jamestiotio/ehp/README.md

# 50.002 1D Part 2: Electronic Hardware Project

SUTD ISTD 2020 Computation Structures Electronic Hardware Project: 16-Bit ALU, ALU Tester & Electronic Game.

Team 03-2:

- [James Raphael Tiovalen](https://github.com/jamestiotio) (Team Leader)
- [Ng Yu Yan](https://github.com/ngyy3487)
- [Sun Kairan](https://github.com/kairanskrr)
- [Cheow Wei Da Nicholas](https://github.com/nicholascwd)
- Jodi Tan Kai Yu
