jamestiotio/ehp/alu/README.md

# 16-Bit Arithmetic Logic Unit (ALU) & ALU Tester

SUTD ISTD 2020 Computation Structures 1D ALU Project.

Team 03-2:

- [James Raphael Tiovalen](https://github.com/jamestiotio) (Team Leader)
- [Ng Yu Yan](https://github.com/ngyy3487)
- [Sun Kairan](https://github.com/kairanskrr)
- [Cheow Wei Da Nicholas](https://github.com/nicholascwd)
- Jodi Tan Kai Yu

## Introduction

In this project, we implemented an Arithmetic Logic Unit (ALU) and its tester in the Alchitry Au FPGA.

## Features

This is the instruction set for the ALU.

> NOTE: X would indicate that that particular bit's value does not matter (whether it is a 0 or 1). In other words, we do not care about the value of the X bit.

| ALUFN[5:0] | Operation | Module |
| --- | --- | --- |
| 00 00X0 | ADD | adder16 |
| 00 00X1 | SUBTRACT | adder16 |
| 00 0100 | MULTIPLY | multiplier16 |
| 00 0101 | FLOOR DIVISION | multiplier16 |
| 00 0110 | SIGNED MODULO | multiplier16 |
| 00 0111 | UNSIGNED MODULO | multiplier16 |
| 00 1000 | INCREMENT X | increment16  |
| 00 1001 | INCREMENT Y | increment16  |
| 00 1010 | DECREMENT X | decrement16  |
| 00 1011 | DECREMENT Y | decrement16  |
| 00 11XX | FACTORIAL | factorial |
| 01 0000 | ZERO | boolean16 |
| 01 0001 | NOR | boolean16 |
| 01 0010 | NOT CONVERSE | boolean16 |
| 01 0011 | NOT 'X' | boolean16 |
| 01 0100 | NOT IMPLY | boolean16 |
| 01 0101 | NOT 'Y' | boolean16 |
| 01 0110 | XOR | boolean16 |
| 01 0111 | NAND | boolean16 |
| 01 1000 | AND | boolean16 |
| 01 1001 | XNOR | boolean16 |
| 01 1010 | 'X' | boolean16 |
| 01 1011 | IMPLY | boolean16 |
| 01 1100 | 'Y' | boolean16 |
| 01 1101 | CONVERSE | boolean16 |
| 01 1110 | OR | boolean16 |
| 01 1111 | ONE | boolean16 |
| 10 0000 | SHIFT LEFT | shifter16 |
| 10 0001 | SHIFT RIGHT | shifter16 |
| 10 0011 | SHIFT RIGHT ARITHMETIC | shifter16 |
| 10 0100 | ROTATE LEFT | shifter16 |
| 10 0101 | ROTATE RIGHT | shifter16 |
| 10 11XX | MIRROR | shifter16 |
| 11 001X | CMPEQ | comparator16 |
| 11 010X | CMPLT | comparator16 |
| 11 011X | CMPLE | comparator16 |
| 11 101X | MAXIMUM | comparator16 |
| 11 110X | MINIMUM | comparator16 |

## Testing

For the ALU tester, we also have two modes: manual and automatic.

To switch between automatic and manual testing mode, press `io_button[2]`.

> These are the in-built buttons of the Alchitry IO shield:
>
> - `io_button[0]` is the up/top button.
> - `io_button[1]` is the centre/middle button.
> - `io_button[2]` is the down/bottom button.
> - `io_button[3]` is the left button.
> - `io_button[4]` is the right button.

For both modes, you can force an error by pressing `io_button[0]` during either mode of testing. This will result in an error-catching state, which is for the purposes of intentional error handling/checking.

- Manual

  During manual testing mode, select the corresponding X and Y values by using `c{io_dip[1], io_dip[0]}`. Press `io_button[1]` to confirm the selected input values of X and Y accordingly and switch between inputting X, inputting Y and displaying the OUTPUT. The `c{io_led[1], io_led[0]}` will display the input values X and Y in real-time during their respective states. Select the associated OPCODE by using `io_dip[2][5:0]`. The OPCODE can be changed at any time and the corresponding correct OUTPUT will be displayed. The values of `io_dip[2][7:6]` will display the current state (10 when inputting X, 01 when inputting Y, and 11 when displaying OUTPUT). When the 7-segments display an "O" (i.e. at OUTPUT state), `c{io_led[1], io_led[0]}` will display the resulting output of the ALU.

- Automatic

  During automatic testing mode, the FSM will continuously cycle through the different test cases listed in the `auto_tester.luc` module. The 7-segments will cycle through this sequence for each test case: "X", INPUT_X, "Y", INPUT_Y, "O", EXPECTED_OUTPUT. As the automatic tester progresses through the pre-defined test cases, `io_led[2][5:0]` will display the current OPCODE function/instruction being tested. If an error is encountered, the letter "E" will be displayed on the 7-segments at the end of that test case. If the tester manages to go through all of the test cases successfully without any errors, the 7-segments will display a letter "d". Once one round of automatic testing is done, another round of automatic testing could be conducted by pressing `io_button[1]` in the `DONE` state without restarting/rebooting/repowering the FPGA.
