jamestiotio/ehp/game/docs/datapath.png

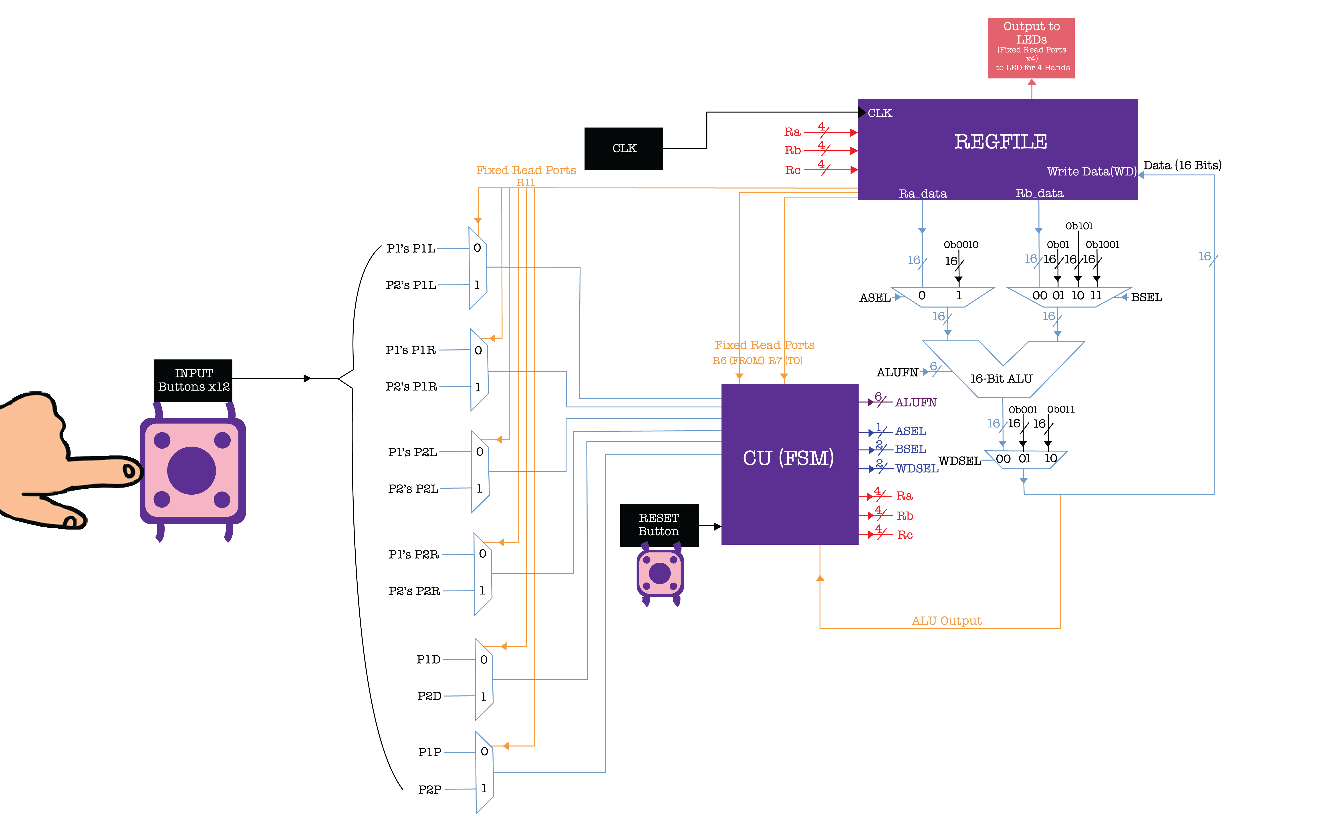
game/docs/datapath.png
