jamestiotio/ehp/game/docs/fsm.png

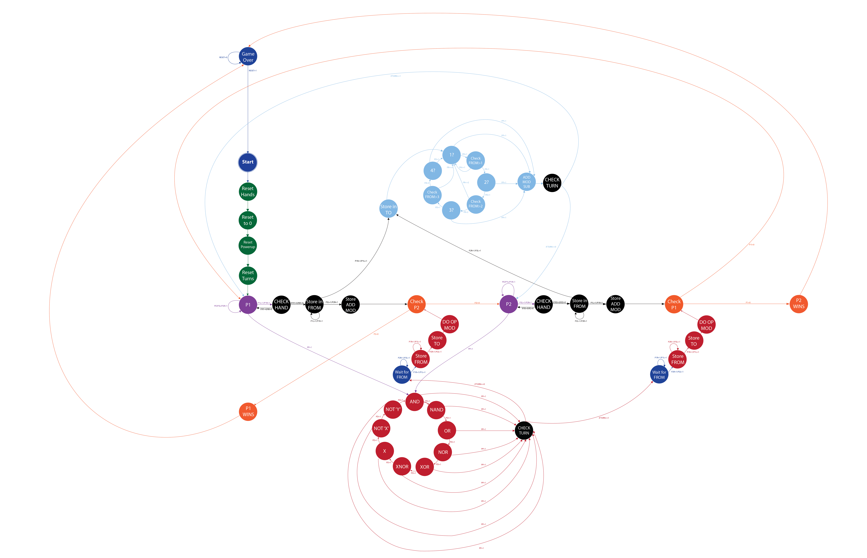
game/docs/fsm.png
