jamestiotio/ehp/game/docs/AlchitryBrElementReference.pdf

# Br Element Reference Notconnected

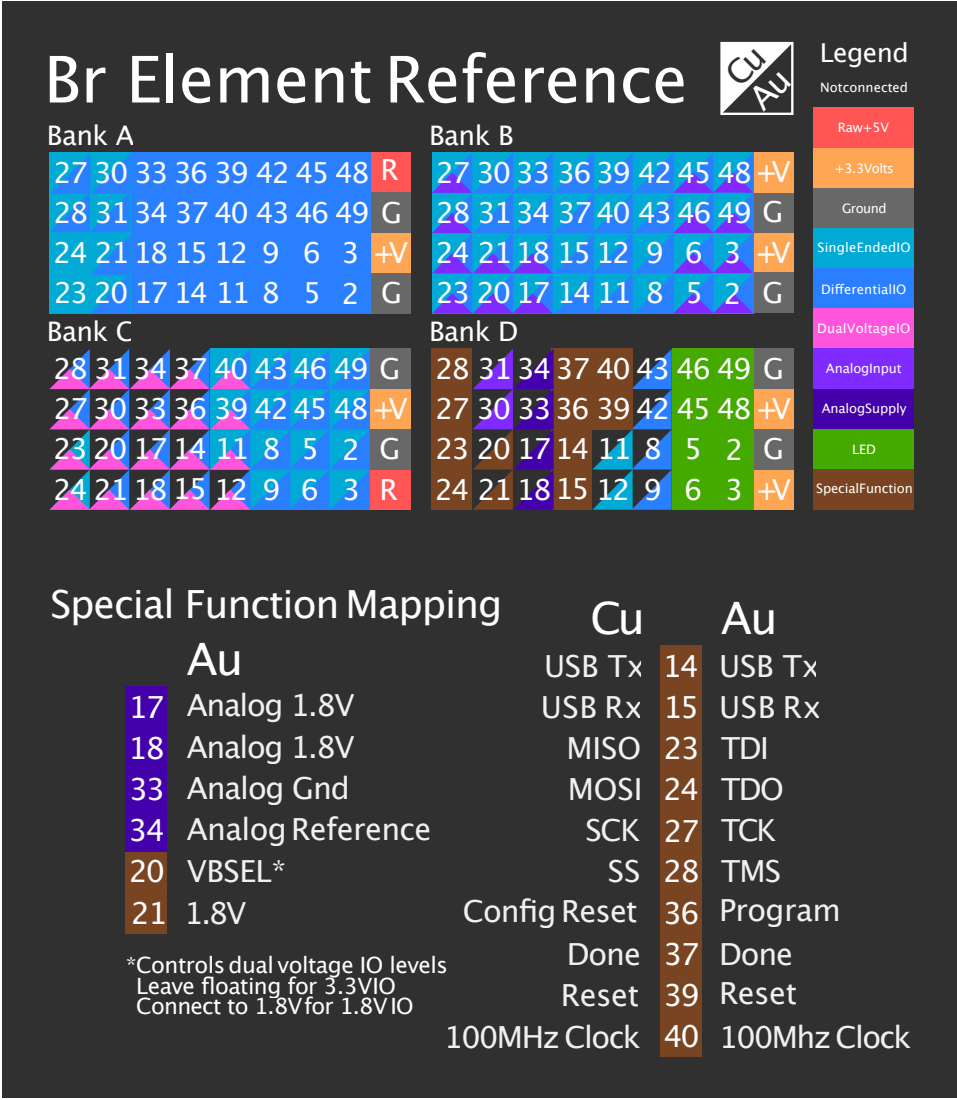
[picture p17: page 1]
Special Function Mapping; VBSEL*; USB Tx; USB Rx; ConfigReset; Program; Done; Reset; 100MHzClock; 100MhzClock; Analog 1.8V; MISO; TDI; Analog Gnd; AnalogReference; MOSI; TDO; SCK; TCK; TMS; +3.3Volts; Ground; Raw+5V; SingleEndedIO; DifferentialIO; DualVoltageIO; AnalogInput; AnalogSupply; LED; SpecialFunction; Legend; Bank A; Bank B; Bank C; Bank D

*Controlsdual voltage IO levels
Leave floating for 3.3VIO
Connect to 1.8Vfor 1.8VIO
