jamestiotio/ehp/game/docs/datapath.pdf

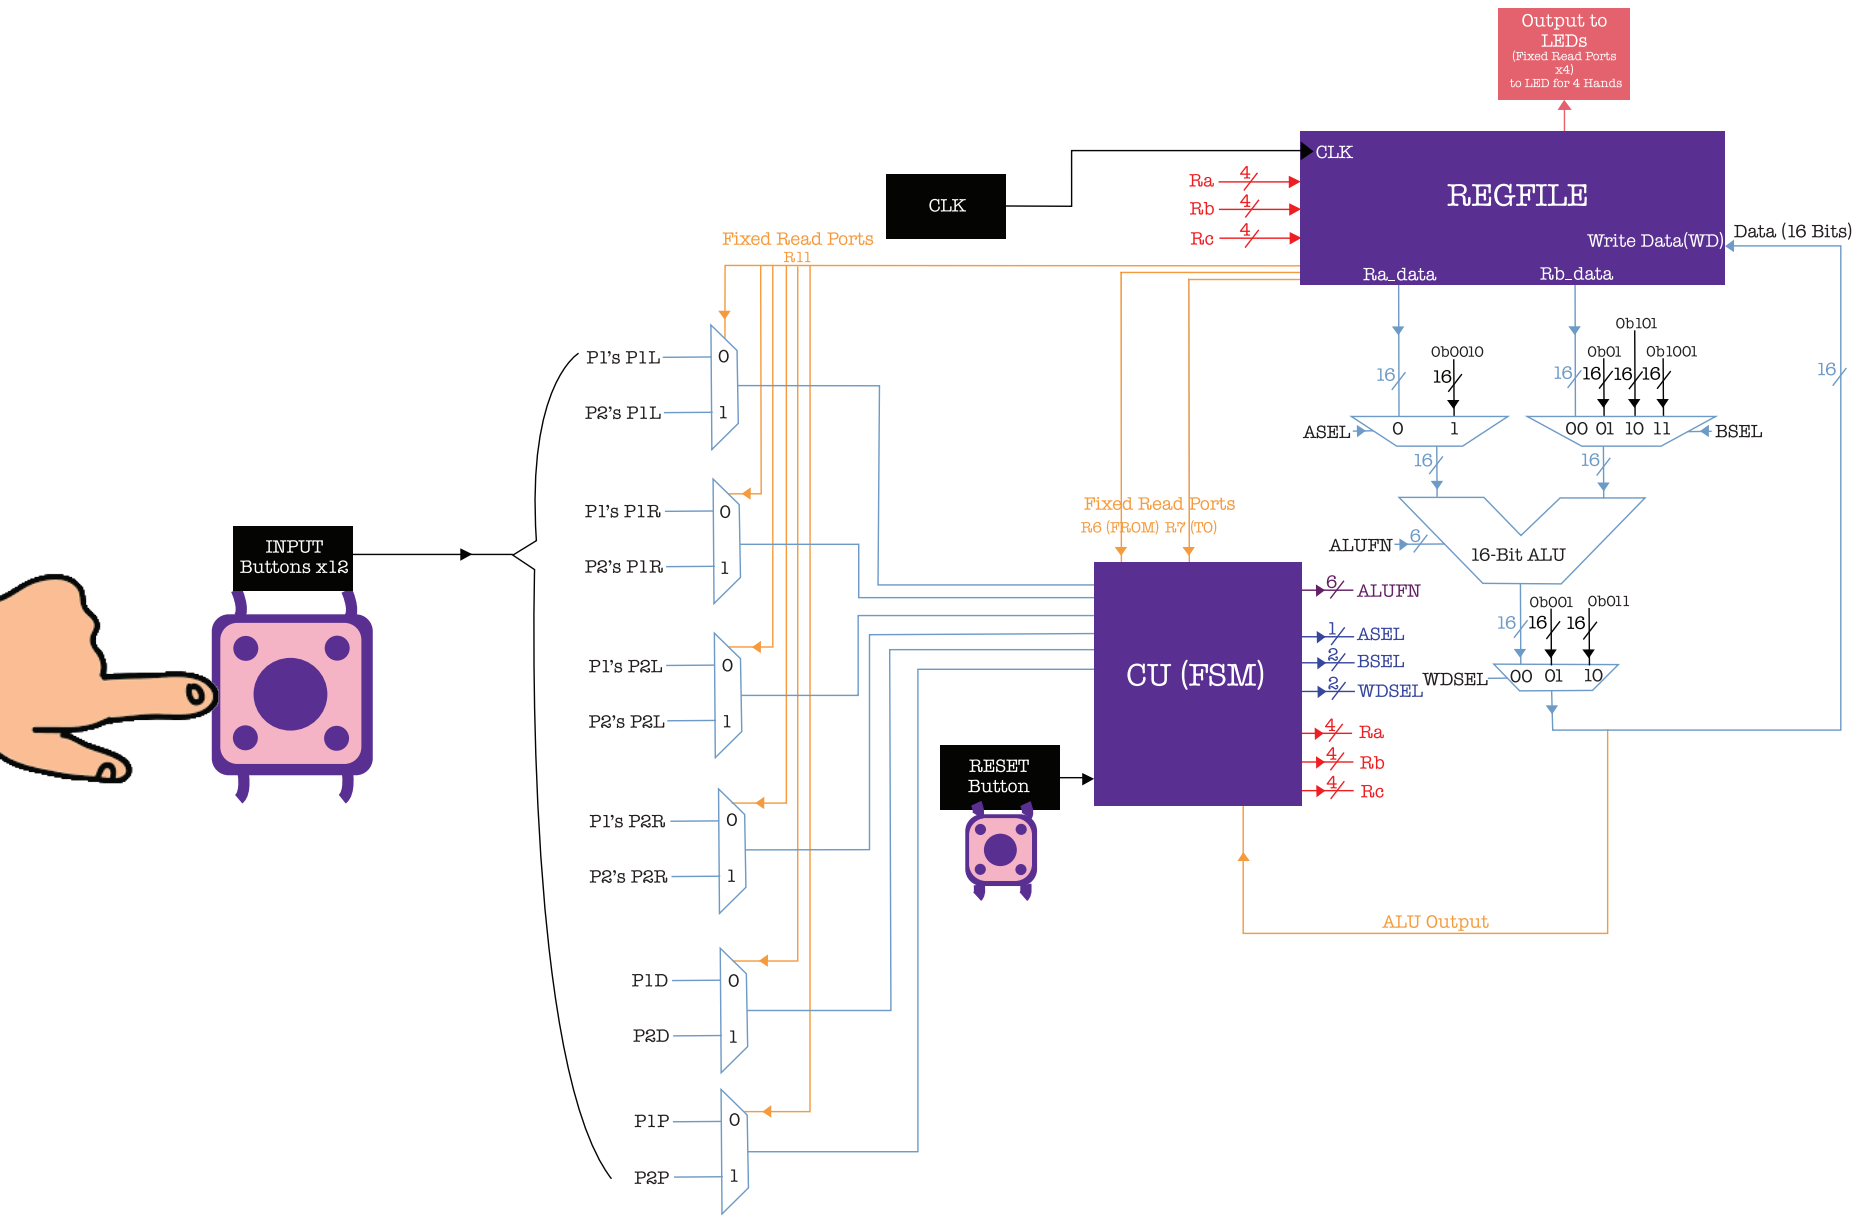
[picture p18: page 1]
