jamestiotio/ehp/game/docs/fsm.pdf

# Game Over

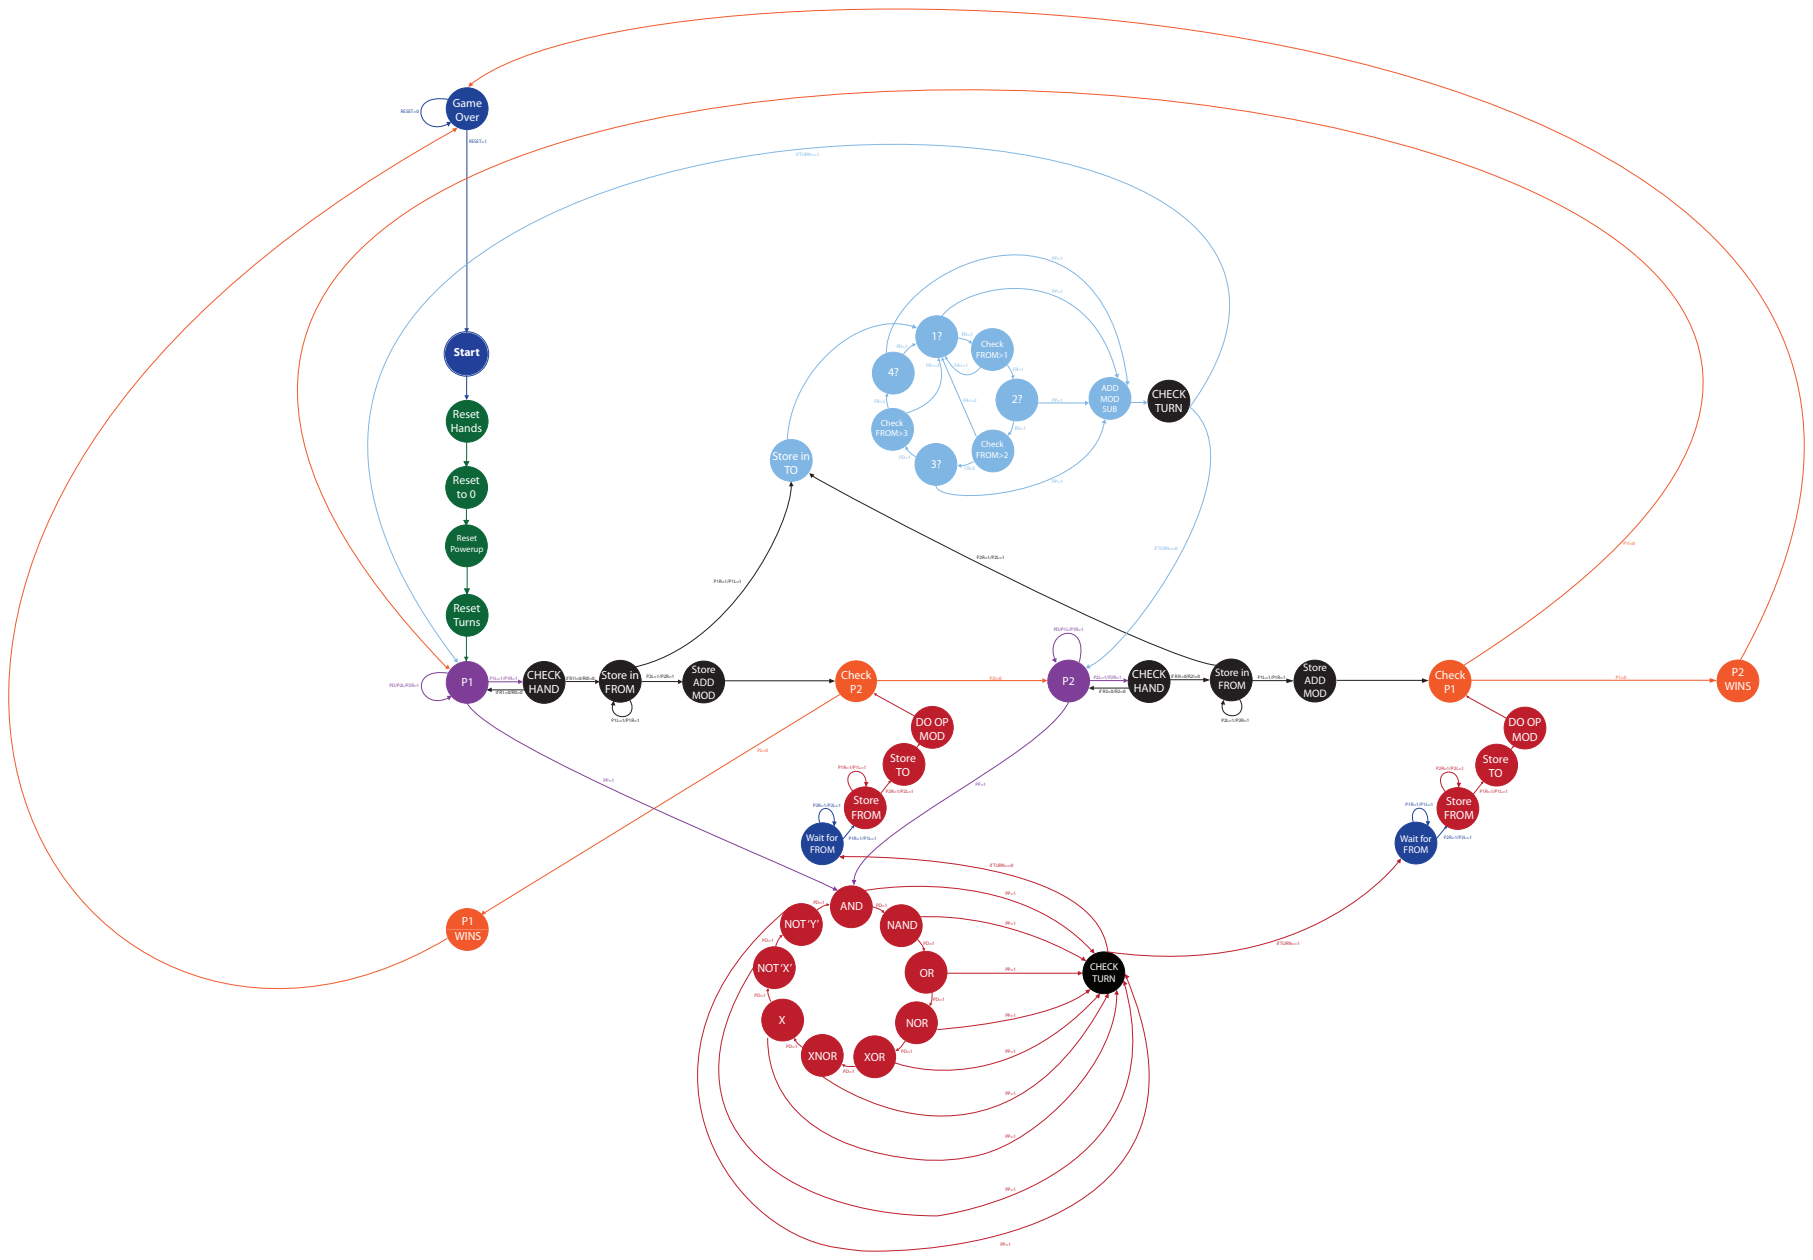
[picture p19: page 1]
Reset Powerup; Reset Hands; Start; RESET=0; RESET=1; Store in FROM; Store ADD MOD; Check; Store in; FROM; CHECK HAND; CHECK; HAND; Reset Turns; P1 WINS; P2 WINS; Reset to 0; Store in TO; CHECK TURN; Check FROM>1; Check FROM>2; Check FROM>3; ADD MOD SUB; if TURN==0; if TURN==1; AND; NAND; NOR; XNOR; XOR; NOT ‘X’; NOT ‘Y’; Store FROM; DO OP MOD; Store TO; Wait for FROM
