jamestiotio/ehp/(commit log)

2020-11-05 Insert multiplier16 module
2020-11-30 added some seven segs files (incomplete) and regfile & button muxes for input to cu(done)
    im confused abt 7 seg AHH
2020-11-30 Add backup of current work [UNGRADED]
    - Add more ALU functionalities
    - Improve error checker of auto and manual testers
2020-12-02 Add individual test case module
2020-12-02 Add custom Br board schematics
2020-12-02 Change state_change button in au_top between PLAY and TEST
2020-12-02 Add clarifying comment over choice of state_change button
2020-12-03 Update ButtonPressTest
2020-12-03 Fix ButtonPressTest
2020-12-03 Update about wiring and tests on README
2020-12-03 Add circuit diagram schematics
    [circuit_diagram.kicad_pcb, circuit_diagram.sch, fpga.sch]
2020-12-07 [ImgBot] Optimize images
    /game/docs/circuit_diagram/digisticks_circuit_diagram.png -- 115.27kb -> 27.83kb (75.86%)
